athemae/DrawBot/Planning prévisionnel des séances .jpg

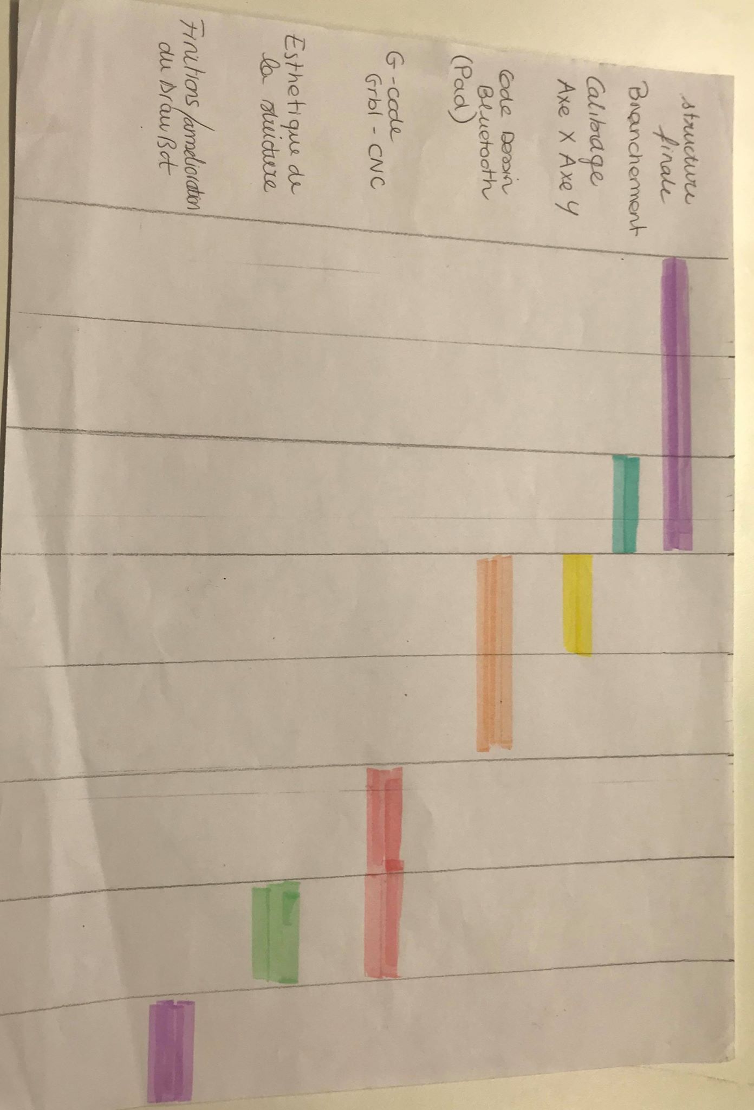
Planning prévisionnel des séances .jpg
