athemae/DrawBot/README.md

# DrawBot
Un robot codé sous Arduino qui dessine 
Pour utiliser le robot :
  -Télégargez l'application GCTRL ici : http://www.instructables.com/files/orig/FF9/2KU1/IHP6UIRQ/FF92KU1IHP6UIRQ.zip
  -Pour avoir accès à l'extension .gcode sous inkscape il faut télécharger sur le github ci-contre (tout y est expliqué) : https://github.com/martymcguire/inkscape-unicorn
  -Téléchargez Inkscape (Attention, l’extension MaketBot Unicorn ne fonctionne pas au delà de la version 0.48.5 d’Inkscape) pour créer vos dessins : https://inkscape.org/fr/release/inkscape-0.92.4/
  
  Puis tout est installé, vous pouvez profiter du DrawBot
