athemae/DrawBot/cahierdescharges.odt

Athéna ALLAIX

Maëlynn MULLER

Cahier des charges

Titre du projet : DrawBot

En quoi consiste notre projet ?

L’objectif de notre DrawBot est qu’il soit capable de reproduire un dessin qui lui sera envoyé de deux manières possibles :

- Depuis un smartphone, l’utilisateur dessinera sur un pad et en même temps, le robot qui recevra les informations à l’aide du module Bluetooth, reproduira les traits.
- Depuis l’ordinateur par un port série, il reproduira une image qui lui aura été envoyée (qui fonctionne comme le CNC plotter).

Description du projet :

A l’aide de deux lecteurs DVD-ROM munis chacun d’un moteur pas à pas, on pourra définir deux axes X et Y qui nous serviront de repère pour la réalisation des dessins. L’un sera fixé en parallèle au sol pour faire translater sur l’axe Y le socle sur lequel on posera la feuille (cf 1 figure 1). L’autre sera positionné perpendiculairement au sol et dessus sera accroché le stylo, il servira à faire bouger le stylo de gauche à droite sur l’axe X (cf 2 figure1). Pour faire en sorte que le crayon puisse se poser sur la feuille ou s’en retirer, on utilisera un servomoteur, qui actionnera le ressort qui lui permettra le mouvement vertical du stylo sur l’axe Z (cf 3 figure 1). On utilisera une carte Arduino Uno ou Nano pour le montage, à laquelle on ajoutera un module Bluetooth HC06.

Pour ce qui est du code, nous formulerons des programmes test qui auront pour rôle de vérifier le bon fonctionnement de chaque composant de notre machine (exemple : test de la translation sur l’axe X et sur l’axe Y pour effectuer le calibrage, test du lever de stylo avec le servomoteur etc.). Ensuite nous utiliserons la bibliothèque GRBL pour le code des déplacements et de la lecture du dessin sur ordinateur. Pour le Bluetooth, nous utiliserons la bibliothèque « SoftwareSerial ».

Objectif de fin de S3 :

On souhaite avoir notre structure finale brute, relié au circuit et à la carte arduino, et on veut les axes X et Y fonctionnels ainsi que l’actionnement du stylo avec le servomoteur.

Objectif de fin de projet :

On souhaite une structure finale esthétique, le projet fonctionnel dans sa totalité avec les deux options.

Budget attendu (se référer à l’annexe Matériel.md pour le détail) :
