athemae/DrawBot/Compte-rendus des séances/MaelynnMULLER/MAELYNN_Compte-rendu_seance3_06_01_2020.pdf

Maëlynn Muller

Compte-rendu 3 : 06/01/2020

DrawBot

Durant les vacances de Noël, Athena est allée chercher au fablab les pièces que nous avions à imprimer pour pouvoir assembler la structure finale, que nous devions absolument faire pendant la séance pour pouvoir avancer dans notre projet et dans les tests des programmes.

Voici les pièces que nous avons imprimées :

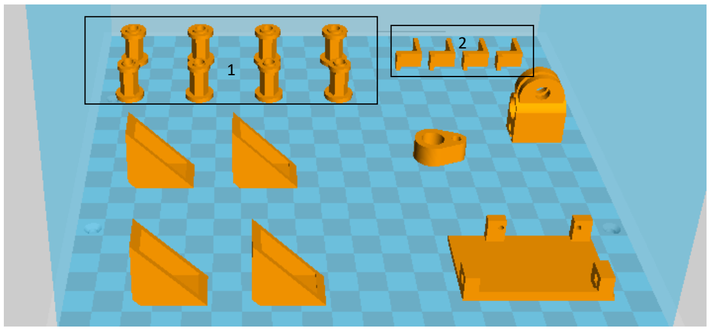
[picture p5: figure]

Au cours de cette séance nous avons donc consacré la totalité du créneau à l’assemblage de notre robot. Pour cette étape nous avons dû travailler en binôme car par exemple pour le perçage de la plaque de bois, l’une devait tenir la structure pendant que l’autre perçait.

J’ai donc découvert l’utilisation de la perceuse, mais aussi d’un appareil capable de tronçonner des vis en les brûlant ! Nous avons dû percer nos plaques de bois pour visser nos deux lecteurs DVD (surélevés par des « écrous » (1 voir photo ci-dessus) faits au fablab), mais aussi pour fixer les deux plaques de bois perpendiculaires à notre plaque horizontale. Je vais mettre des photos de la structure ci-dessous afin de mieux comprendre les tâches que nous avions à effectuer :

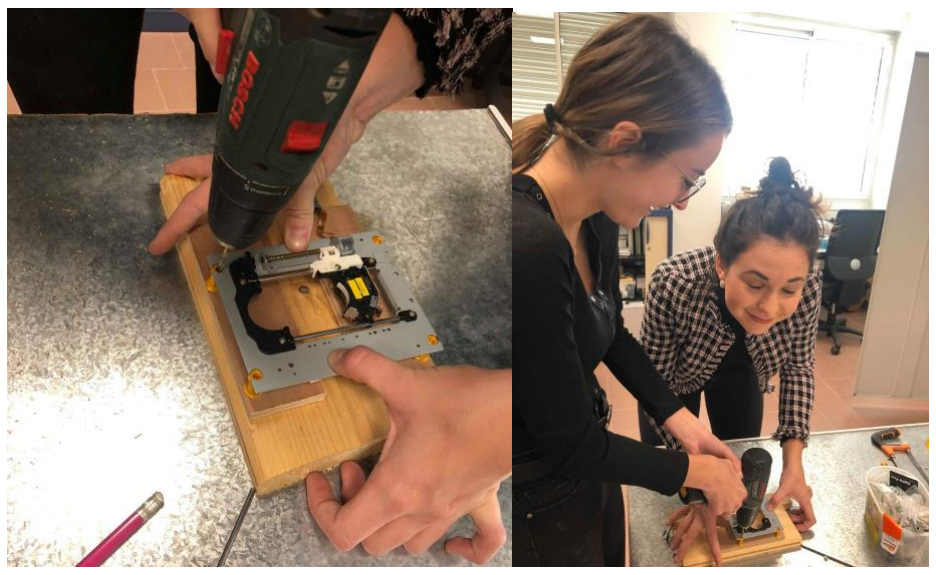
[picture p6: figure]

L’étape de perçage : Athena tient la structure et moi la perçeuse.

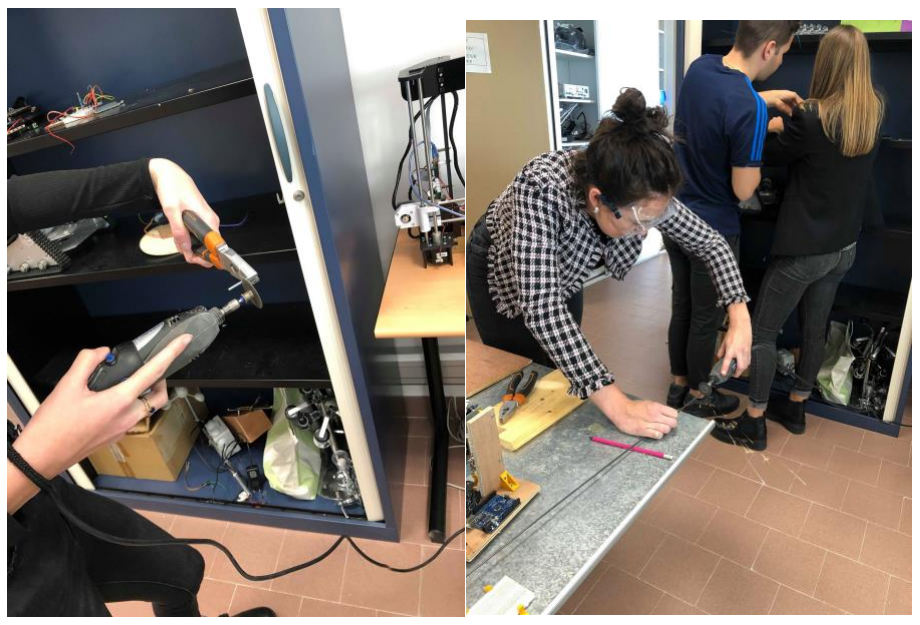
[picture p7: figure]

L’étape de la « tronçonneuse » pour couper les vis trop longues

Nous avons donc obtenu cette structure

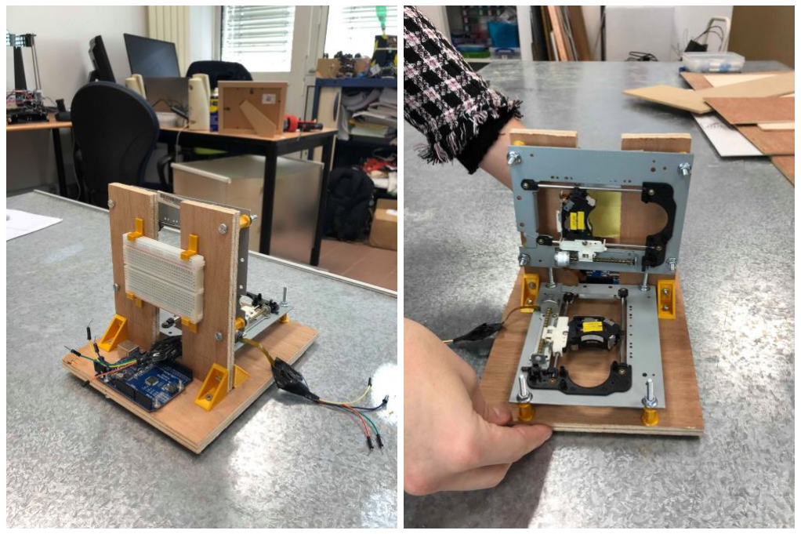
[picture p8: figure]

Face arrière | Face avant

Nous avons donc fixé à l’aide de vis nos plaques de bois ensemble,sur lesquelles ont a fixé nos lecteurs et la carte arduino. Quant au breadbord on l’a fixé grâce aux composants 2 (voir premiere photo) imprimés au fablab. On les a collé au pistolet à colle sur la stucture en bois directement.

Il nous restera donc le montage du circuit, le crayon à rajouter avec le servomoteur, et le support de dessin où l’on placera la feuille. Puis place aux programmes !
