athemae/DrawBot/Pièces imprimante 3D/equerres_breadboard.stl

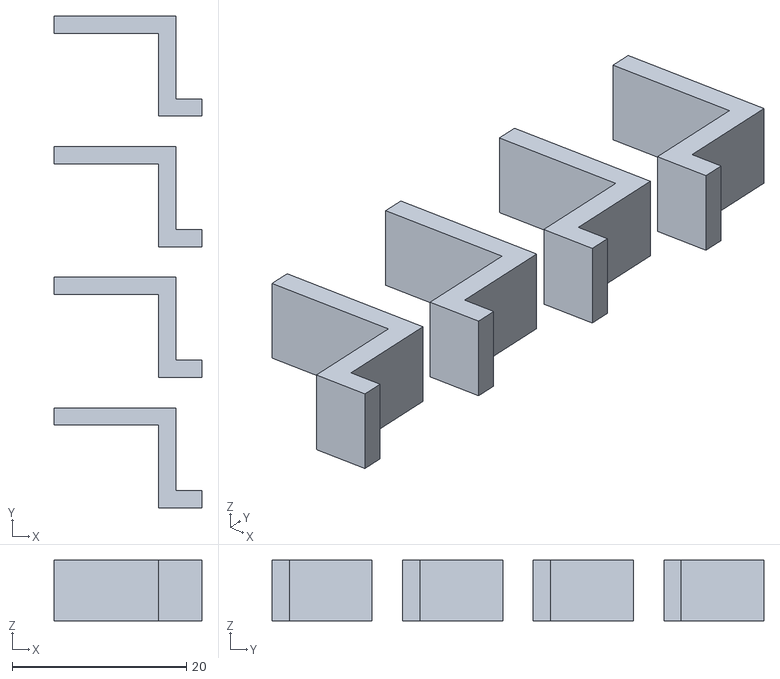
[picture p51: CAD file, 2020-01-13]
Pièces imprimante 3D/equerres_breadboard.stl
17.0 x 56.5 x 7.00
