athemae/DrawBot/Pièces imprimante 3D/entretoises.stl

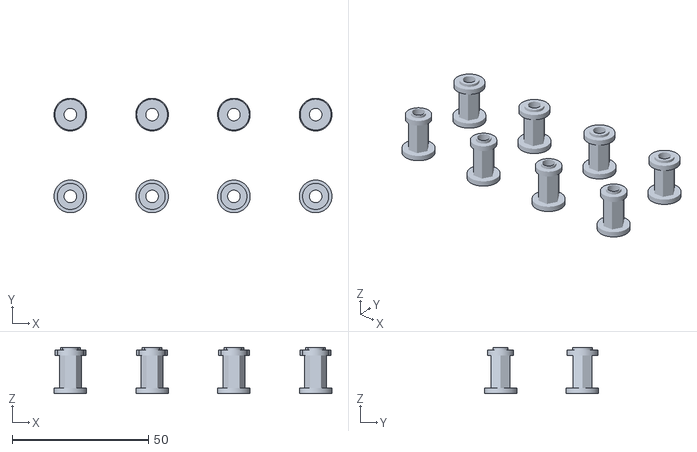
[picture p52: CAD file, 2020-01-13]
Pièces imprimante 3D/entretoises.stl
102.0 x 42.0 x 17.0
