athemae/DrawBot/Pièces imprimante 3D/support.stl

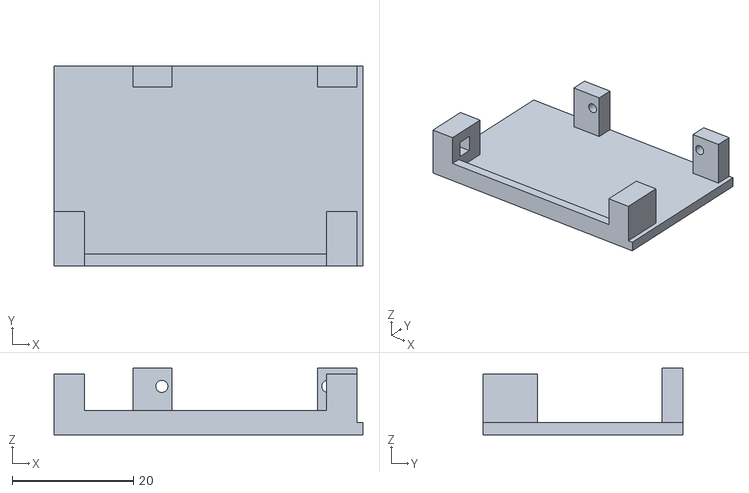
[picture p53: CAD file, 2020-01-13]
Pièces imprimante 3D/support.stl
51.0 x 33.0 x 11.0
