athemae/DrawBot/Pièces imprimante 3D/porte_crayon.stl

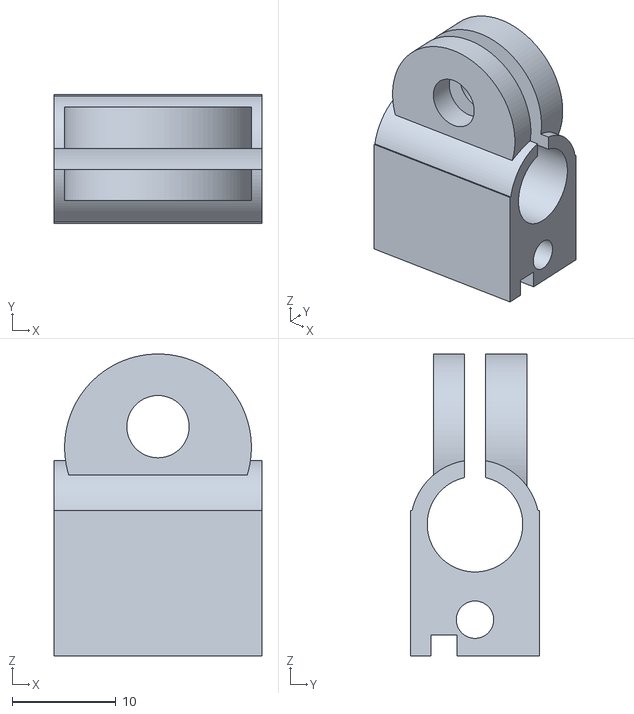
[picture p54: CAD file, 2020-01-13]
Pièces imprimante 3D/porte_crayon.stl
20.0 x 12.4 x 29.1
