athemae/DrawBot/Pièces imprimante 3D/equerres.stl

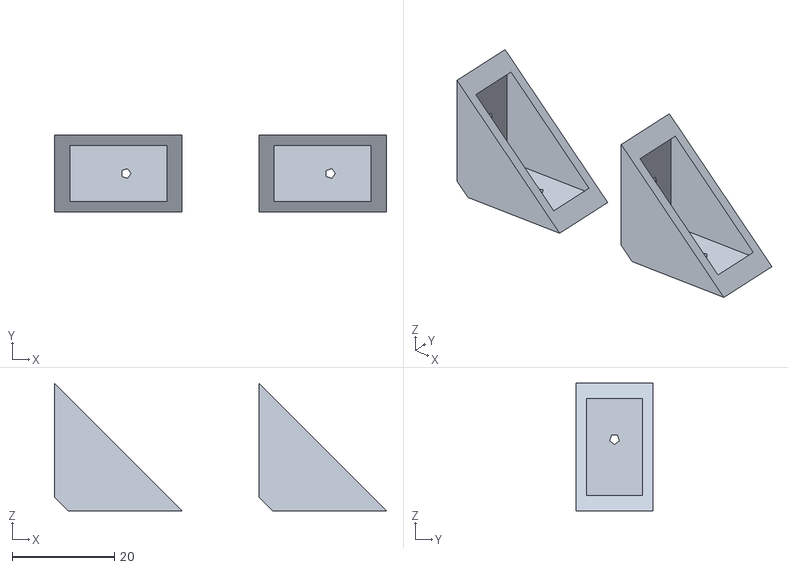
[picture p55: CAD file, 2020-01-13]
Pièces imprimante 3D/equerres.stl
65.0 x 15.0 x 25.0
