athemae/DrawBot/Pièces imprimante 3D/anti-basculement.stl

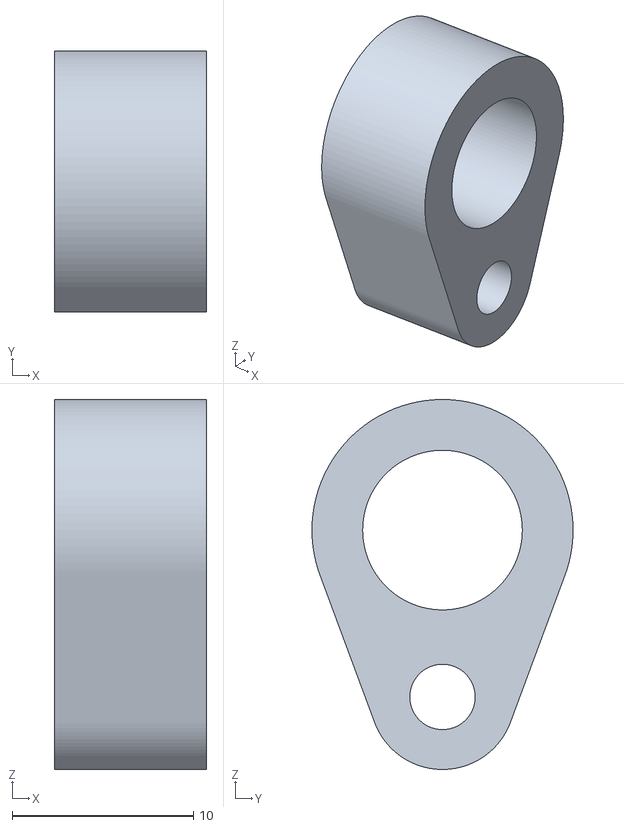
[picture p56: CAD file, 2020-01-13]
Pièces imprimante 3D/anti-basculement.stl
8.40 x 14.4 x 20.4
