athemae/DrawBot/(commit log)

2019-11-27 Create Compte-rendus des séances
2020-03-11 Add files via upload
    Diaporama utilisé lors de l'oral
